ponoor/TimerStrobeKit/README.md

# TimerStrobeKit
A simple Arduino shield for timer and strobe

### BOM list
https://docs.google.com/spreadsheets/d/1uPikIjkAWC3uok0h-zIkFJXL1ukJnj77JqhKgZAHLNc/edit?usp=sharing
