ponoor/TimerStrobeKit/Hardware/schematic.pdf

A

A

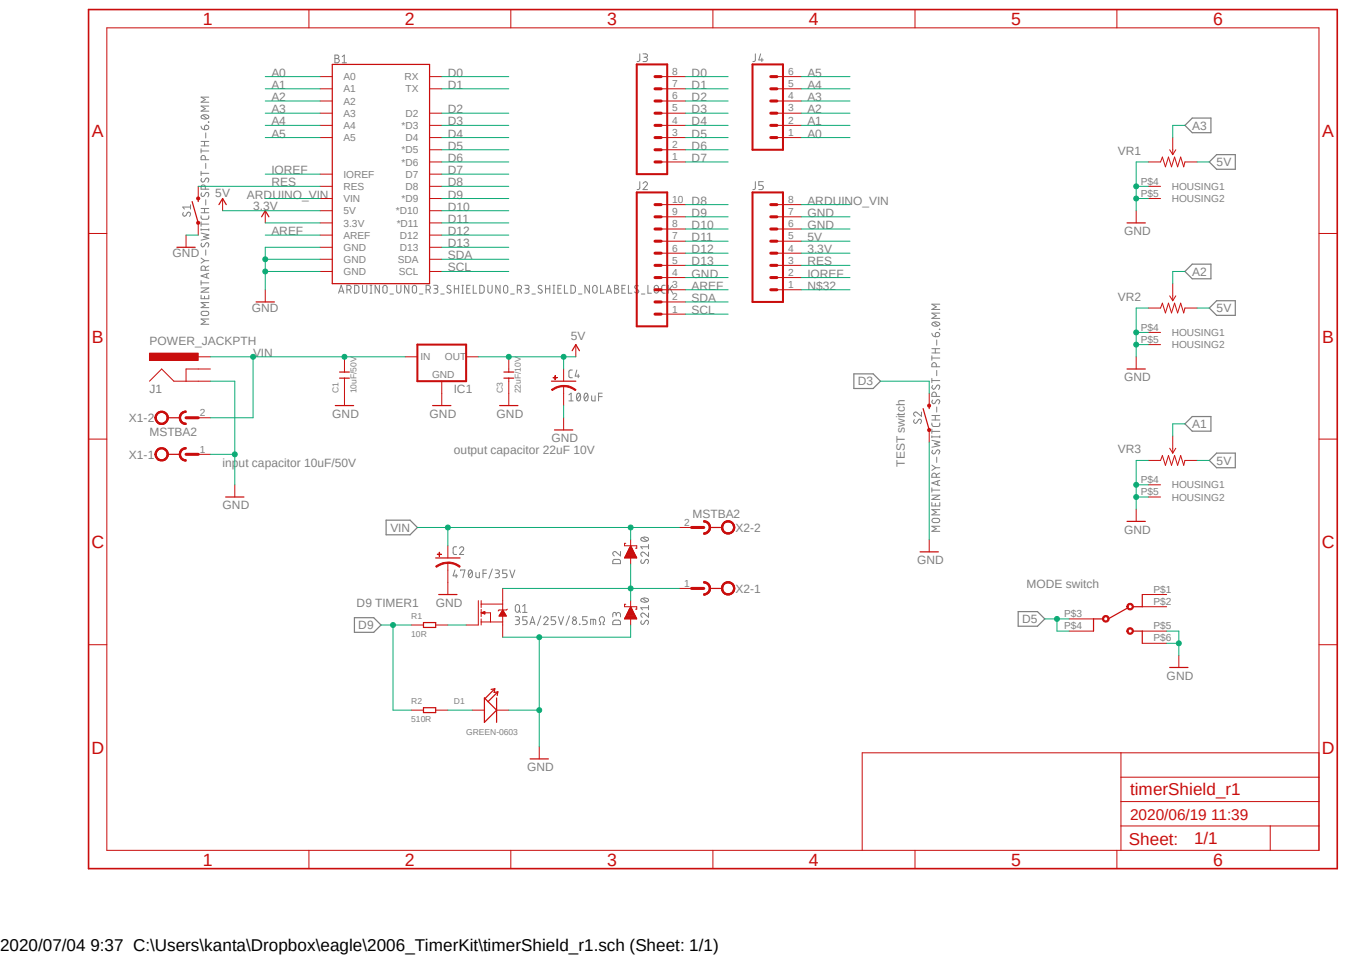
[picture p1: page 1]

MODE switch TEST switch

2020/07/04 9:37 C:\Users\kanta\Dropbox\eagle\2006_TimerKit\timerShield_r1.sch (Sheet: 1/1)
