ponoor/TimerStrobeKit/Hardware/Eagle/timerShield_r1.brd

## EAGLE design Hardware/Eagle/timerShield_r1.brd (2020-07-04)

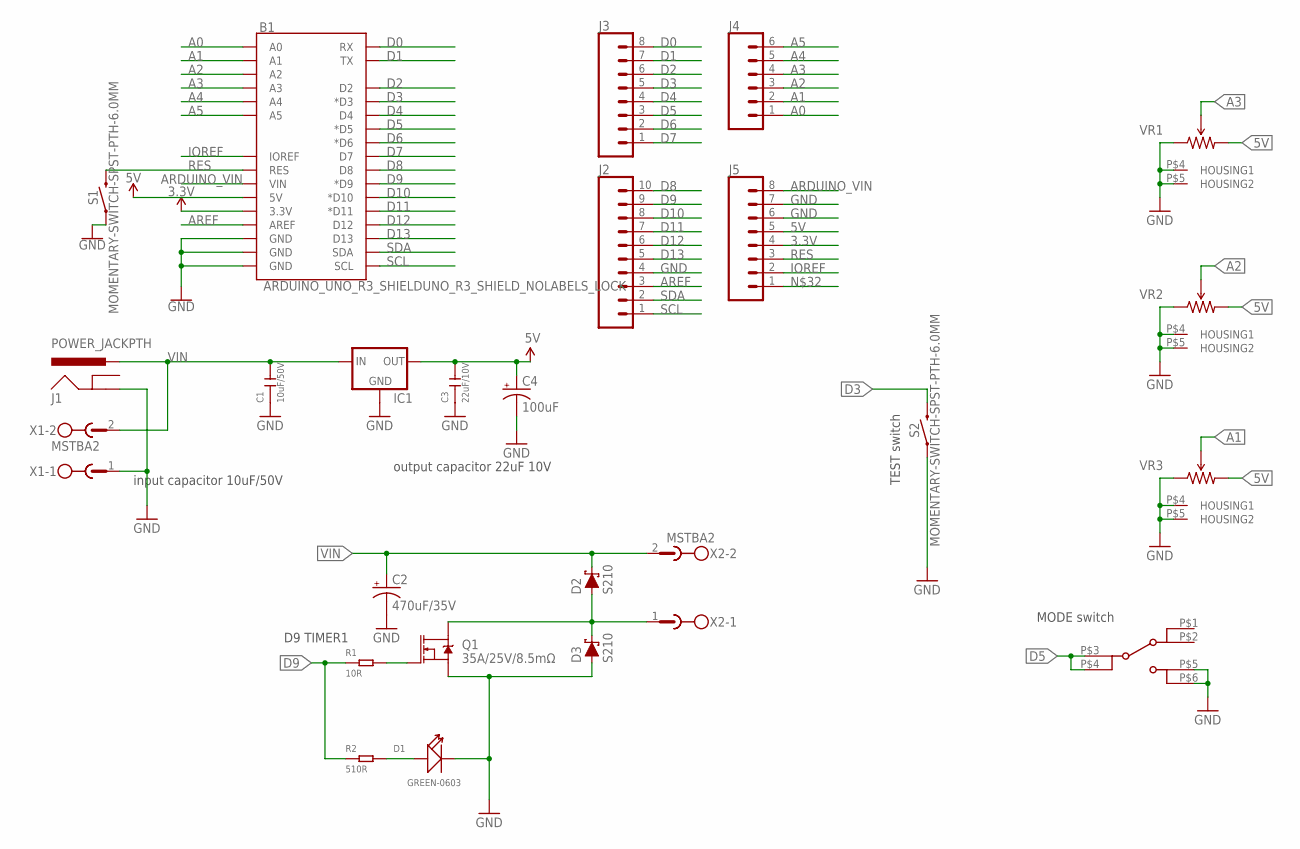
[picture p2: schematic timerShield_r1.sch]

Parts:
B1: ARDUINO_UNO_R3_SHIELDUNO_R3_SHIELD_NOLABELS_LOCK; UNO_R3_SHIELD_NOLABELS_LOCK
C1: 10uF/50V; C1206
C2: 470uF/35V; CPOL-RADIAL-5MM-10MM-KIT
C3: 22uF/10V; C0805
C4: 100uF; CPOL-RADIAL-2.5MM-6.5MM
D1: GREEN-0603; LED-0603
D2, D3: S210; SMA-DIODE
IC1: V_REG_78XX_K78XX-500R3; K78XX-500R3
J1: POWER_JACKPTH; POWER_JACK_PTH
J2: CONN_10"; 1X10
J3, J5: CONN_08"; 1X08
J4: CONN_06SILK_FEMALE_PTH; 1X06
MODE: SW_SSSS213202NARROW; SW-SSSS213202NARROW
Q1: 35A/25V/8.5mΩ; DPAK
R1: 10R; R0603
R2: 510R; R0603
S1, S2: MOMENTARY-SWITCH-SPST-PTH-6.0MM; TACTILE_SWITCH_PTH_6.0MM
VR1, VR2, VR3: TRIMVR_HOUSING_RK09; RK09
X1, X2: MSTBA2

Connections:
3.3V: B1.3.3V, J5.4
5V: B1.5V, C3.2, C4.1 (+), IC1.3 (OUT), J5.5, VR1.3 (CW), VR2.3 (CW), VR3.3 (CW)
A0: B1.A0, J4.1
A1: B1.A1, J4.2, VR3.2 (WIPER)
A2: B1.A2, J4.3, VR2.2 (WIPER)
A3: B1.A3, J4.4, VR1.2 (WIPER)
A4: B1.A4, J4.5
A5: B1.A5, J4.6
ARDUINO_VIN: B1.VIN, J5.8
AREF: B1.AREF, J2.3
D0: B1.RX, J3.8
D1: B1.TX, J3.7
D2: B1.D2, J3.6
D3: B1.D3 (*D3), J3.5, S2.3 (2)
D4: B1.D4, J3.4
D5: B1.D5 (*D5), J3.3, MODE.P$3 (2-1), MODE.P$4 (2-2)
D6: B1.D6 (*D6), J3.2
D7: B1.D7, J3.1
D8: B1.D8, J2.10
D9: B1.D9 (*D9), J2.9, R1.1, R2.1
D10: B1.D10 (*D10), J2.8
D11: B1.D11 (*D11), J2.7
D12: B1.D12, J2.6
D13: B1.D13, J2.5
GND: B1.GND@0 (GND), B1.GND@1 (GND), B1.GND@2 (GND), C1.1, C2.-, C3.1, C4.2 (-), D1.-, D3.A, IC1.2 (GND), J1.GND, J2.4, J5.6, J5.7, MODE.P$5 (3-1), MODE.P$6 (3-2), Q1.3 (S), S1.1, S2.1, VR1.1 (CCW), VR1.P$4 (HOUSING1), VR1.P$5 (HOUSING2), VR2.1 (CCW), VR2.P$4 (HOUSING1), VR2.P$5 (HOUSING2), VR3.1 (CCW), VR3.P$4 (HOUSING1), VR3.P$5 (HOUSING2), X1.1
IOREF: B1.IOREF, J5.2
unnamed: Q1.1 (G), R1.2
unnamed: D1.+, R2.2
unnamed: D2.A, D3.C, Q1.4 (D), X2.1
RES: B1.RES, J5.3, S1.3 (2)
SCL: B1.SCL, J2.1
SDA: B1.SDA, J2.2
VIN: C1.2, C2.+, D2.C, IC1.1 (IN), J1.PWR, X1.2, X2.2

Notes on the sheet:
input capacitor 10uF/50V
output capacitor 22uF 10V
D9 TIMER1
MODE switch
TEST switch

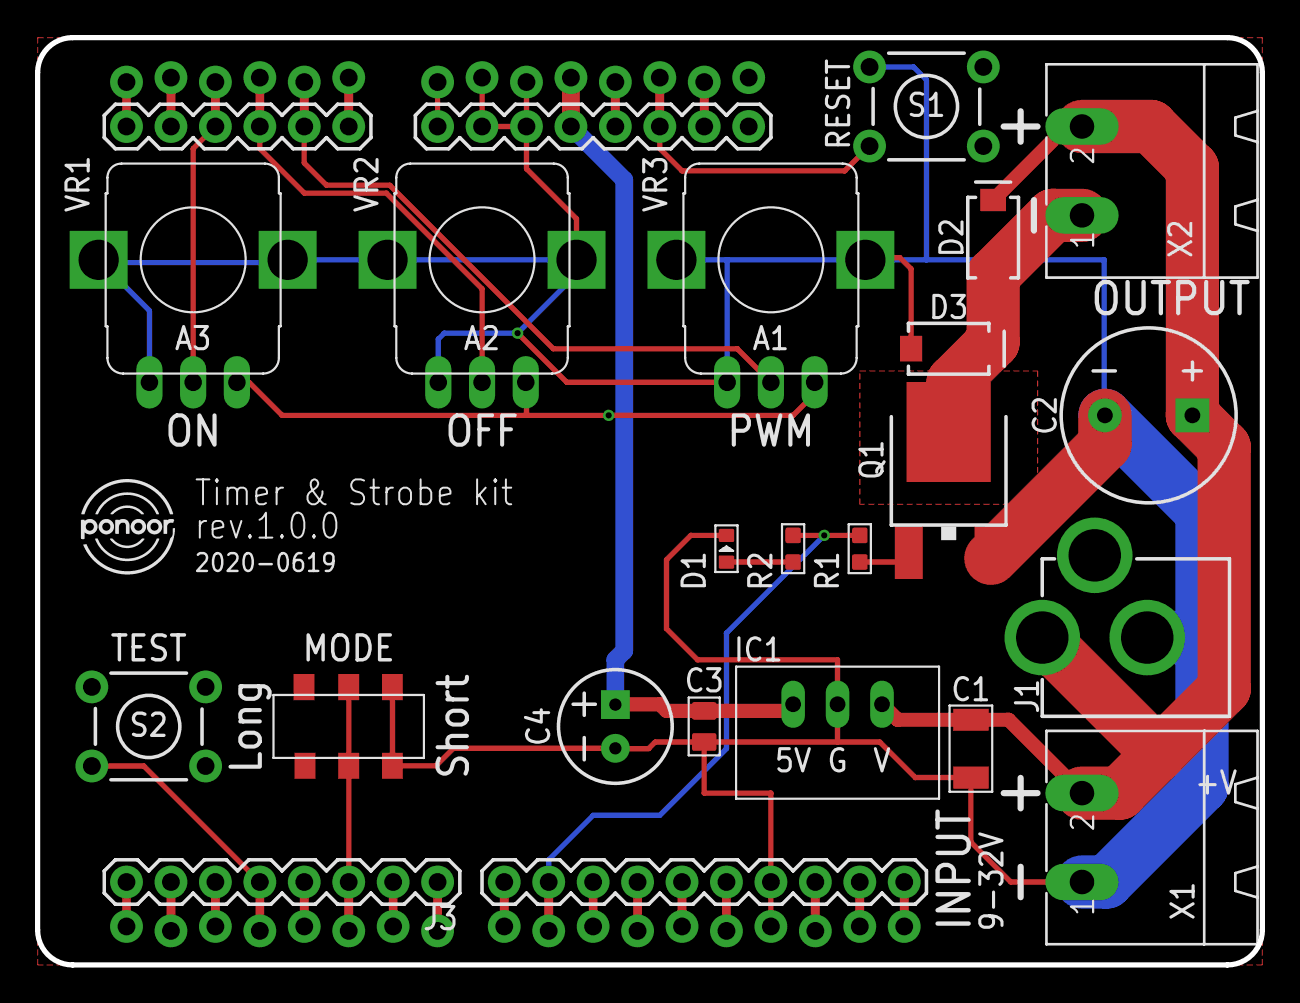
[picture p3: board timerShield_r1.brd from above]

Board: 2 copper layers, 70.0 x 53.0 mm, 27 parts (1 on the bottom side), 33 nets.

Other parts of the board:
U$1: PONOOR_LOGO_6MM
U$2: PONOOR_TEXT_15MM
