ponoor/TimerStrobeKit/(commit log)

2020-07-04 added Eagle files and Arduino code.
    [timerShield_r1.brd, timerShield_r1.sch]
2021-07-04 added BOM list
    [Timer & Strobe Shield Kit - timerShield_r1_BOM.csv]
2022-05-27 Correct timer interrupt bug, added exponential curve for a strobe mode
    [main.cpp]
